GMOhangingAround/stm32f722-flight-controller/hardware/bom.csv

ID | Name | Designator | Footprint | Quantity | Manufacturer Part | Manufacturer | Supplier | Supplier Part | Price | Pins | JLCPCB Part Class
1 | 1uF | C5,C7 | C0402 | 2 | CL05A105KO5NNNC | SAMSUNG(三星) | LCSC | C29266 | 0.019 | 2 | Extended Part
2 | 4.7uF | C8,C24 | C0402 | 2 | CL05A475KP5NRNC | SAMSUNG(三星) | LCSC | C368809 | 0.017 | 2 | Extended Part
3 | 10nF | C9 | C0402 | 1 | CL05B103KB5NNNC | SAMSUNG(三星) | LCSC | C15195 | 0.005 | 2 | Basic Part
4 | 22uF | U6,U7 | C0402 | 2 | GRM158R61A226ME15D | muRata(村田) | LCSC | C3845593 | 0.795 | 2 | Extended Part
5 | 100nF | C6,C11,C13 | C0603 | 3 | CC0603KRX7R9BB104 | YAGEO(国巨) | LCSC | C14663 | 0.024 | 2 | Basic Part
6 | 22uF | C14 | C0805 | 1 | CGA0805X5R226M350MT | HRE(芯声) | LCSC | C6119901 | 0.3 | 2 | Extended Part
7 | 10uF | C15 | C0805 | 1 | GRM21BR61H106KE43L | muRata(村田) | LCSC | C440198 | 0.325 | 2 | Basic Part
8 | SMBJ30A_C83851 | D3 | SMB_L4.4-W3.6-LS5.4-RD | 1 | SMBJ30A | Littelfuse(美国力特) | LCSC | C83851 | 0.13 | 2 | Extended Part
9 | 4.7uH | L2 | IND-SMD_L3.0-W3.0_AFE303020S | 1 | XRTC303020D4R7MBCA | XR(祥如) | LCSC | C39846837 | 0.177 | 2 | Extended Part
10 | TPS73633DBVR | U4 | SOT-23-5_L3.0-W1.7-P0.95-LS2.8-BR | 1 | TPS73633DBVR | TI(德州仪器) | LCSC | C28038 | 0.507 | 5 | Extended Part
11 | AP63205WU-7 | U5 | TSOT-23-6_L2.9-W1.6-P0.95-LS2.8-BL | 1 | AP63205WU-7 | DIODES(美台) | LCSC | C2071056 | 0.44 | 6 | Extended Part
12 | 100nF | C2,C4,C3,C22 | C0402 | 4 | GRM155R71H104KE14D | muRata(村田) | LCSC | C77020 | 0.021 | 2 | Extended Part
13 | FCM1608KF-601T03 | L1,L3 | L0603 | 2 | FCM1608KF-601T03 | TAI-TECH(台庆) | LCSC | C141723 | 0.012 | 2 | Extended Part
14 | 10kΩ | R2,R3,R5,R6 | R0402 | 4 | RC0402FR-0710KL | YAGEO(国巨) | LCSC | C60490 | 0.006 | 2 | Extended Part
15 | DPS310XTSA1 | U2 | LGA-8_DPS310XTSA1 | 1 | DPS310 | Infineon(英飞凌) | LCSC | C130156 | 6.955 | 8 | Extended Part
16 | 100kΩ | R10 | R0603 | 1 | RC0603FR-07100KL | YAGEO(国巨) | LCSC | C14675 | 0.007 | 2 | Extended Part
17 | 10kΩ | R11,R12 | R0603 | 2 | RC0603FR-0710KL | YAGEO(国巨) | LCSC | C98220 | 0.008 | 2 | Extended Part
18 | 100nF | C17,C10,C18,C19,C20,C21 | C0402 | 6 | CC0402KRX7R9BB104 | YAGEO(国巨) | LCSC | C131394 | 0.016 | 2 | Extended Part
19 | 1uF | C23 | C0402 | 1 | GRM155R61H105KE05D | muRata(村田) | LCSC | C1518208 | 0.092 | 2 | Extended Part
20 | 4.7uF | C25 | C0603 | 1 | GRM188R61E475KE11D | muRata(村田) | LCSC | C90057 | 0.074 | 2 | Extended Part
21 | 100mΩ | R15 | R0402 | 1 | PE0402FRF070R1L | YAGEO(国巨) | LCSC | C1883533 | 0.05 | 2 | Extended Part
22 | SM08B-SRSS-TB(LF)(SN) | MOTORS | CONN-TH_SM08B-SRSS-TB-LF-SN | 1 | SM08B-SRSS-TB(LF)(SN) | JST | LCSC | C160407 | 0.331 | 10 | Extended Part
23 | HX 3X4X2-2P-1.6N TACTILE SWITCH | BOOT,RESET | KEY-SMD_L4.0-W3.0-LS4.9-1 | 2 | HX 3x4x2-2P-1.6N TACTILE SWITCH | hanxia(韩下) | LCSC | C49234124 | 0.023 | 2 | Extended Part
24 | 10nF | C1 | C0402 | 1 | GRM155R71H103KA88D | muRata(村田) | LCSC | C77019 | 0.017 | 2 | Extended Part
25 | 27pF | C12,C16 | C0402 | 2 | GCM1555C1H270JA16D | muRata(村田) | LCSC | C126504 | 0.012 | 2 | Extended Part
26 | 2.2uF | U3 | C0402 | 1 | GRM155Z71A225KE01D | muRata(村田) | LCSC | C2997286 | 0.096 | 2 | Extended Part
27 | USBLC6-2P6 | D1 | SOT-666-6_L1.6-W1.2-P0.50-LS1.6-BR | 1 | USBLC6-2P6 | ST(意法半导体) | LCSC | C15999 | 0.278 | 6 | Extended Part
28 | B340A-13-F | D2 | SMA_L4.4-W2.6-LS5.0-RD | 1 | B340A-13-F | DIODES(美台) | LCSC | C85098 | 0.087 | 2 | Extended Part
29 | FC-DA1608BK-470H10 | STATUS | LED0603-RD | 1 | NCD0603B1 | 国星光电 | LCSC | C84266 | 0.018 | 2 | Extended Part
30 | 5.1kΩ | R1,R4 | R0402 | 2 | 0402WGF5101TCE | UNI-ROYAL(厚声) | LCSC | C25905 | 0.007 | 2 | Basic Part
31 | R3X1 | R1X1 | R0402 | 1 | RC0402FR-0733RL | YAGEO(国巨) | LCSC | C138002 | 0.006 | 2 | Extended Part
32 | 33Ω | R7,R8,R9 | R0402 | 3 | RC0402FR-0733RL | YAGEO(国巨) | LCSC | C138002 | 0.006 | 2 | Extended Part
33 | 100Ω | R13,R16 | R0402 | 2 | RC0402FR-07100RL | YAGEO(国巨) | LCSC | C106232 | 0.004 | 2 | Extended Part
34 | 1kΩ | R14 | R0402 | 1 | RC0402FR-071KL | YAGEO(国巨) | LCSC | C106235 | 0.006 | 2 | Extended Part
35 | SM05B-SRSS-TB (LF)(SN) | SWD,VTX | CONN-SMD_SM05B-SRSS-TB-LF-SN | 2 | SM05B-SRSS-TB(LF)(SN) | JST | LCSC | C136657 | 0.297 | 7 | Extended Part
36 | GND | GND,GND,GND,GND,GND | TEST_TESTPOINT | 5 |  |  |  |  |  | 1
37 | 5V | 5V,5V | TEST_TESTPOINT | 2 |  |  |  |  |  | 1
38 | CAM | CAM,CAM | TEST_TESTPOINT | 2 |  |  |  |  |  | 1
39 | TX3 | RX2,TX2,TX3,TX1,RX1 | TEST_TESTPOINT | 5 |  |  |  |  |  | 1
40 | M4 | M4 | TEST_TESTPOINT | 1 |  |  |  |  |  | 1
41 | M3 | M3 | TEST_TESTPOINT | 1 |  |  |  |  |  | 1
42 | M2 | M2 | TEST_TESTPOINT | 1 |  |  |  |  |  | 1
43 | M1 | M1 | TEST_TESTPOINT | 1 |  |  |  |  |  | 1
44 | TLM | TLM | TEST_TESTPOINT | 1 |  |  |  |  |  | 1
45 | CUR | CUR | TEST_TESTPOINT | 1 |  |  |  |  |  | 1
46 | RX3 | RX3 | TEST_TESTPOINT | 1 |  |  |  |  |  | 1
47 | 3V3 | 3V3 | TEST_TESTPOINT | 1 |  |  |  |  |  | 1
48 | SWDIO | SWDIO | TEST_TESTPOINT | 1 |  |  |  |  |  | 1
49 | SWCLK | SWCLK | TEST_TESTPOINT | 1 |  |  |  |  |  | 1
50 | VBAT | BAT,BAT | TEST_TESTPOINT | 2 |  |  |  |  |  | 1
51 | ICM-42688-P | U1 | LGA-14_L3.0-W2.5-P0.50-TL | 1 | ICM-42688-P | TDK InvenSense(应美盛) | LCSC | C1850418 | 17.001 | 14 | Extended Part
52 | STM32F722RET6 | U8 | LQFP-64_L10.0-W10.0-P0.50-LS12.0-BL | 1 | STM32F722RET6 | ST(意法半导体) | LCSC | C118207 | 11.112 | 64 | Extended Part
53 | MH1 | U9 | M3_MOUNTING_HOLE_3MM | 1 |  |  |  |  |  | 1
54 | MH2 | U10 | M3_MOUNTING_HOLE_3MM | 1 |  |  |  |  |  | 1
55 | MH3 | U11 | M3_MOUNTING_HOLE_3MM | 1 |  |  |  |  |  | 1
56 | MH4 | U12 | M3_MOUNTING_HOLE_3MM | 1 |  |  |  |  |  | 1
57 | SM04B-SRSS-TB (LF)(SN) | UART | CONN-SMD_4P-P1.00_SM04B-SRSS-TB-LF-SN | 1 | SM04B-SRSS-TB(LF)(SN) | JST | LCSC | C160404 | 0.428 | 6 | Extended Part
58 | TYPE-C 16PIN 2MD(073) | USB1 | USB-C-SMD_TYPE-C-6PIN-2MD-073 | 1 | TYPE-C 16PIN 2MD(073) | SHOU HAN(首韩) | LCSC | C2765186 | 0.074 | 16 | Extended Part
59 | 8MHz | X | CRYSTAL-SMD_L5.0-W3.2_Y503211.0592MLCC2S | 1 | XG1EL89CRI-111YLC-8M | YXC Crystal Oscillators | LCSC | C20617997 | 0.259 | 2 | Extended Part
