GMOhangingAround/stm32f722-flight-controller/simulation/Buck.asc

C1: cap; 22µ
C2: cap; 10µ
C3: cap; 100n
C4: cap; 22µ
C5: cap; 22µ
C6: cap; 10n
C7: cap; 1µ
L1: ind; 4.7µ; Rser=1m
R1: res; 10
R2: res; 0.1
R3: res; 47k
R4: res; 510k
R5: res; 123k
R6: res; 5
U1: LT8610
V1: voltage; 22.2
V2: voltage; PULSE(0 25 5m 100n 100n 20u 100m)
Named nets: VBAT, 0, VOUT
X1 0 VBAT SMBJ30AQ
.lib C:\\Users\\gaile\\AppData\\Local\\LTspice\\lib\\sub\\SMBJ30AQ.lib
.tran 0 20m 0 startup
