GMOhangingAround/stm32f722-flight-controller/simulation/FerriteBead.asc

C1: cap; 0.3µF
L1: ind; 1.43µ; Rser=1m
R1: res; 0.5
V1: voltage; SINE(0 1); AC 1
Named nets: 0, VDDA
.ac dec 100 10k 1G
