GMOhangingAround/stm32f722-flight-controller/(commit log)

2026-07-30 Update README
    Add design information, pin mapping and build notes
2026-07-30 Add hardware design files
    [bom.csv, pick-and-place.csv]
2026-07-30 Add firmware files
    [cli-diff.txt]
2026-07-30 Enhance README with simulation details and updates
    Added details about LTspice simulations and transient responses with and without the TVS diode. Updated notes on power distribution and repository layout.
